JVRaj/RoboChampions/schemes/Electromechanical Connections.jpeg

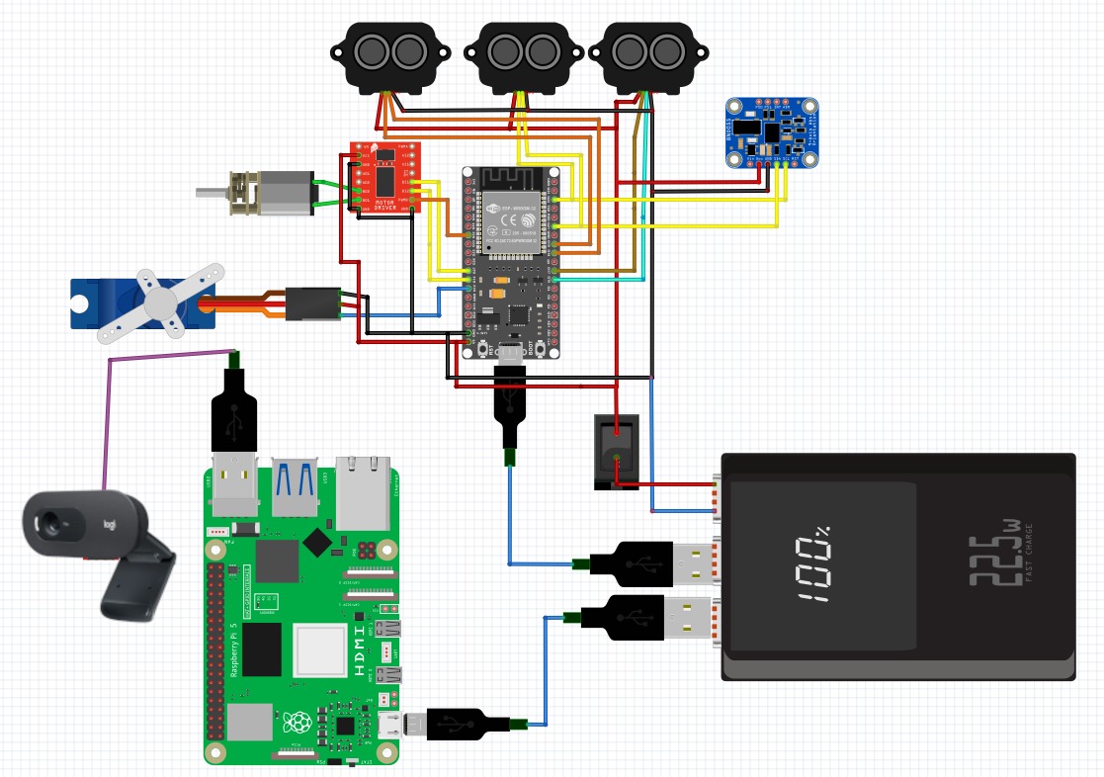
schemes/Electromechanical Connections.jpeg
