JVRaj/RoboChampions/schemes/Final Schematics.jpeg

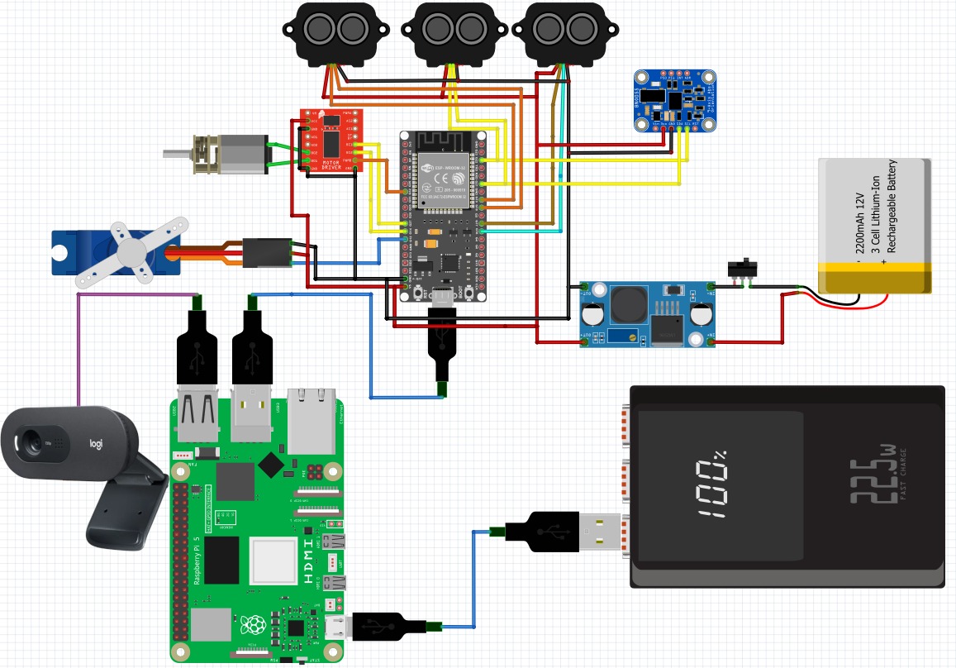
schemes/Final Schematics.jpeg
