JVRaj/RoboChampions/t-photos/README.md

# Team Photos

This directory contains all the photos of our team.

Ranveer Sharma

IMG-20260812-WA0009

Jaivardhan

WhatsApp Image 2025-08-28 at 19 53 20
