JVRaj/RoboChampions/models/README.md

# 3D Models

The following drive link contains the final 3D CAD file created for our robot:
https://drive.google.com/file/d/1nPrlHhIy_s0_yM9g3Fy4j3n5QFtJ1JX9/view?usp=share_link
