JVRaj/RoboChampions/schemes/README.md

# Electromechanical Schematics

This directory contains the electromechanical schematics for our robot.
