JVRaj/RoboChampions/circut diagram/PHOTO-2026-08-15-13-00-35.jpg

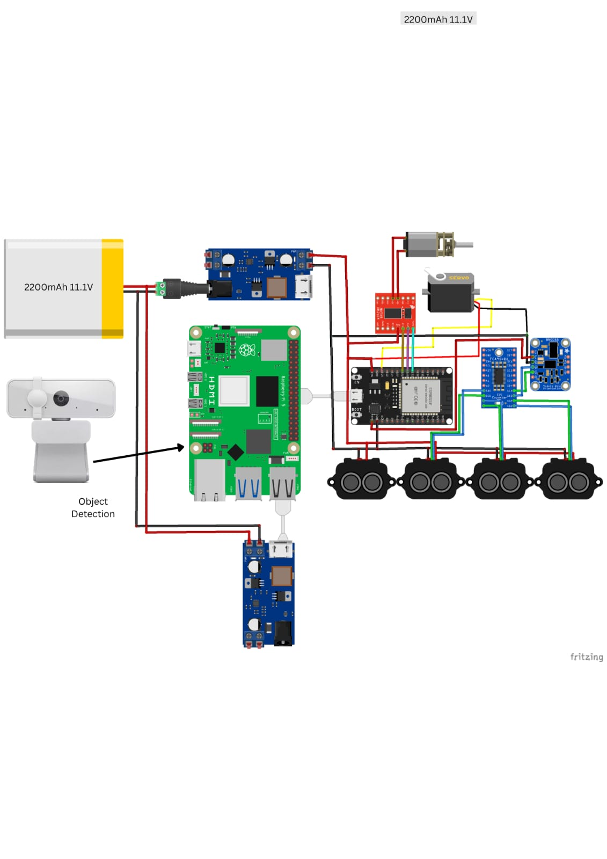
circut diagram/PHOTO-2026-08-15-13-00-35.jpg
