JVRaj/RoboChampions/Round 1 code logic .png

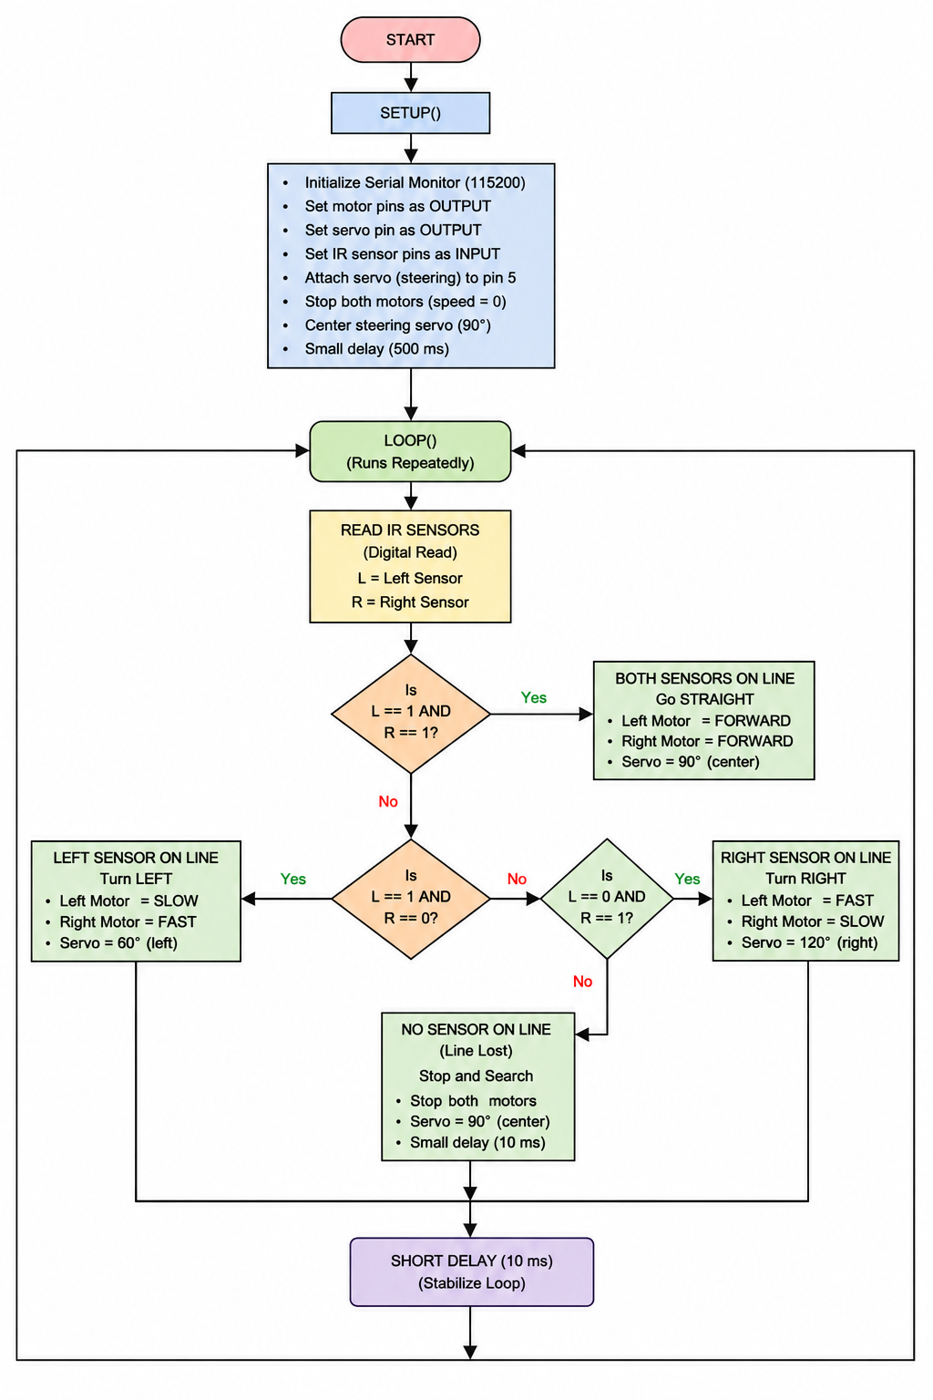
Round 1 code logic .png
