JVRaj/RoboChampions/t-photos/funny.jpg

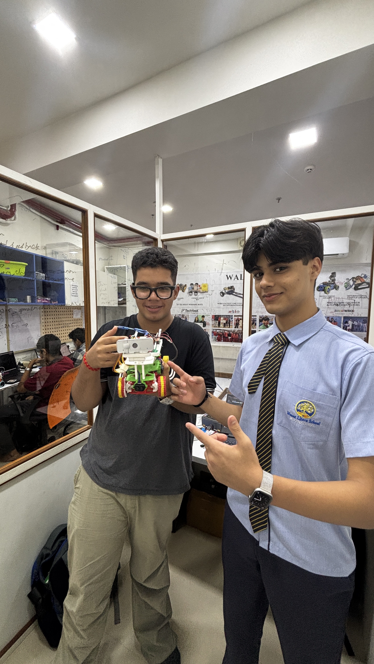
t-photos/funny.jpg
