JVRaj/RoboChampions/t-photos/official.jpg

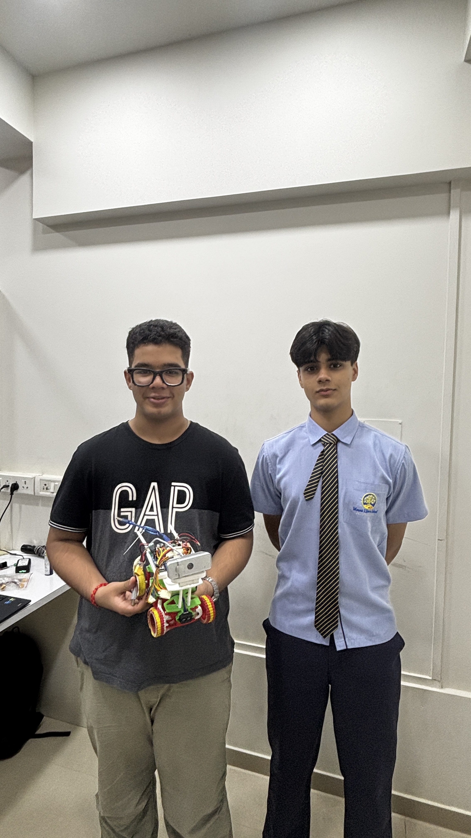
t-photos/official.jpg
