JVRaj/RoboChampions/v-photos/IMG_2718.jpg

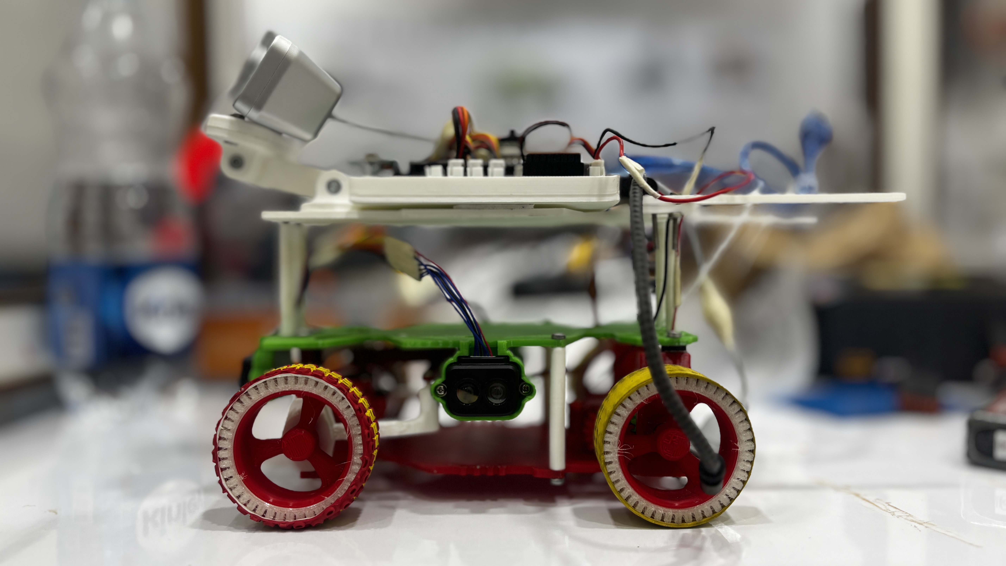
v-photos/IMG_2718.jpg
