JVRaj/RoboChampions/v-photos/IMG_2719.jpg

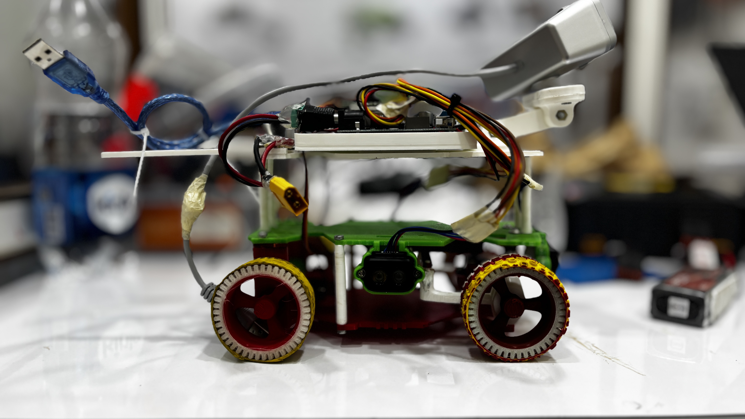
v-photos/IMG_2719.jpg
