JVRaj/RoboChampions/v-photos/IMG_2720.jpg

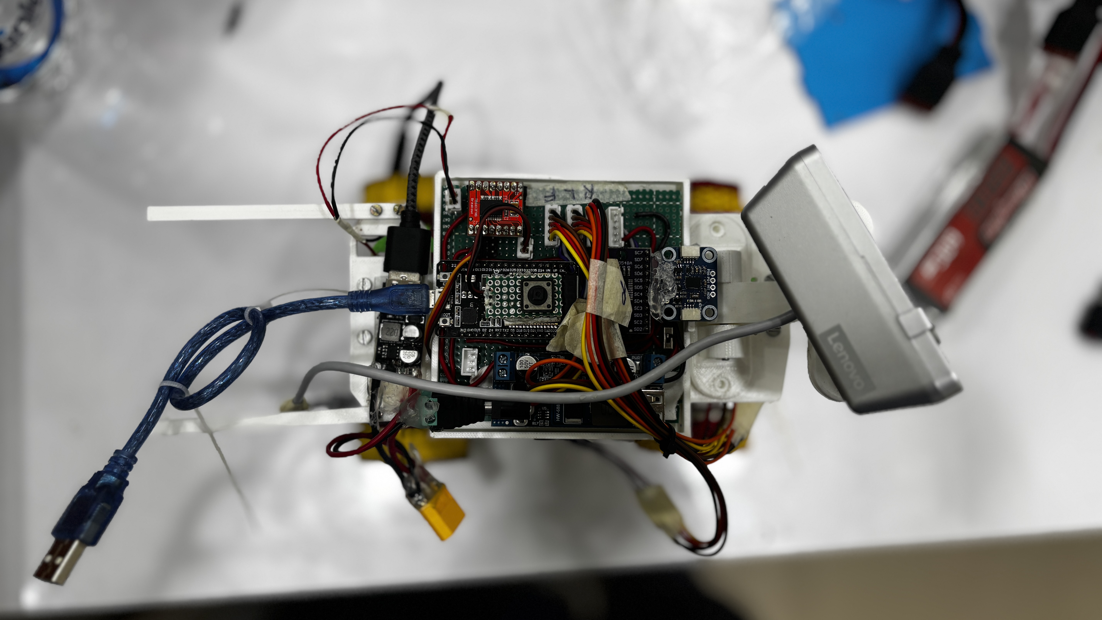
v-photos/IMG_2720.jpg
