JVRaj/RoboChampions/v-photos/IMG_2721.jpg

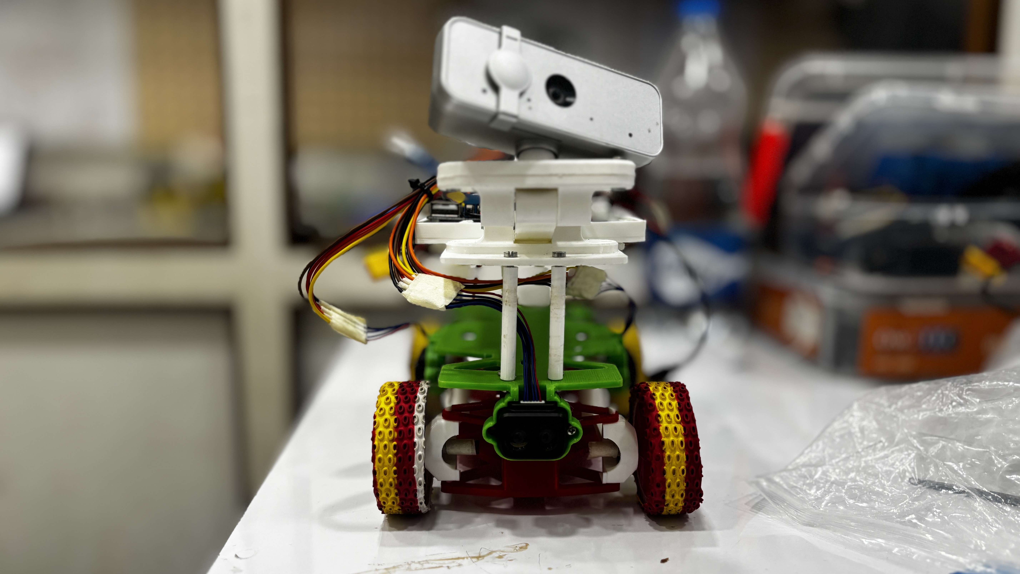
v-photos/IMG_2721.jpg
