JVRaj/RoboChampions/v-photos/IMG_2722.jpg

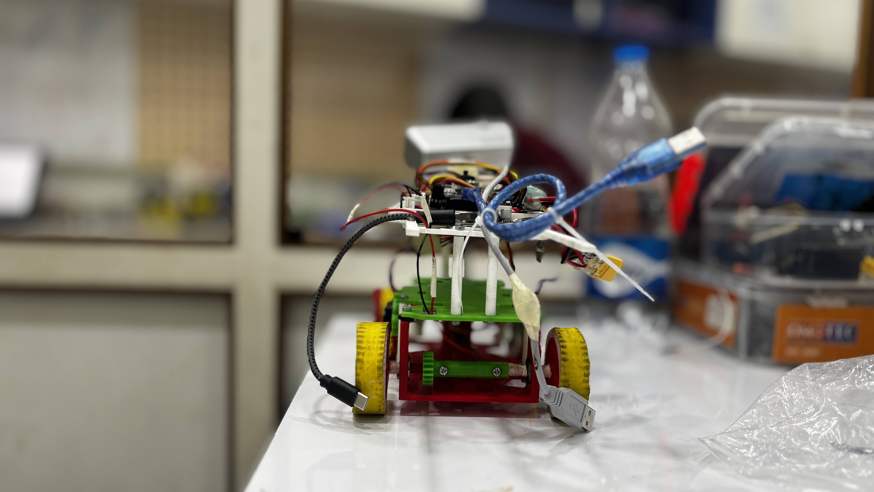
v-photos/IMG_2722.jpg
