JVRaj/RoboChampions/v-photos/IMG_2723.jpg

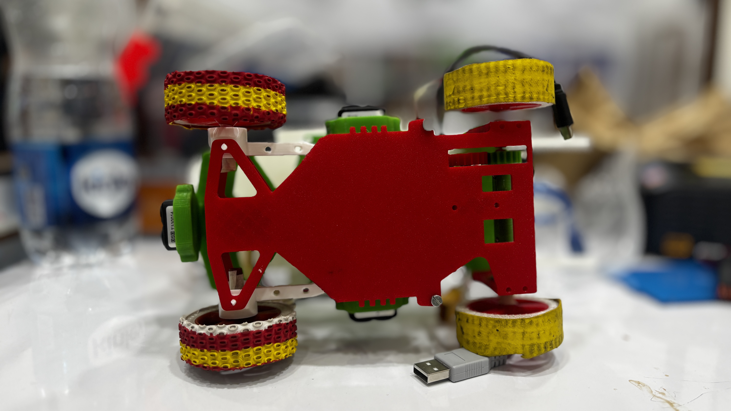
v-photos/IMG_2723.jpg
