JVRaj/RoboChampions/(commit log)

2025-08-28 Created the directory for schematics
2025-08-28 Added the visual for the schematics
2025-08-29 Updated Schematics
